Peersen/Blinkenlights/PCB_Blinkenlights_Stubnitz/Blinkenlights_Stubnitz/Blinkenlights_Stubnitz.jpg

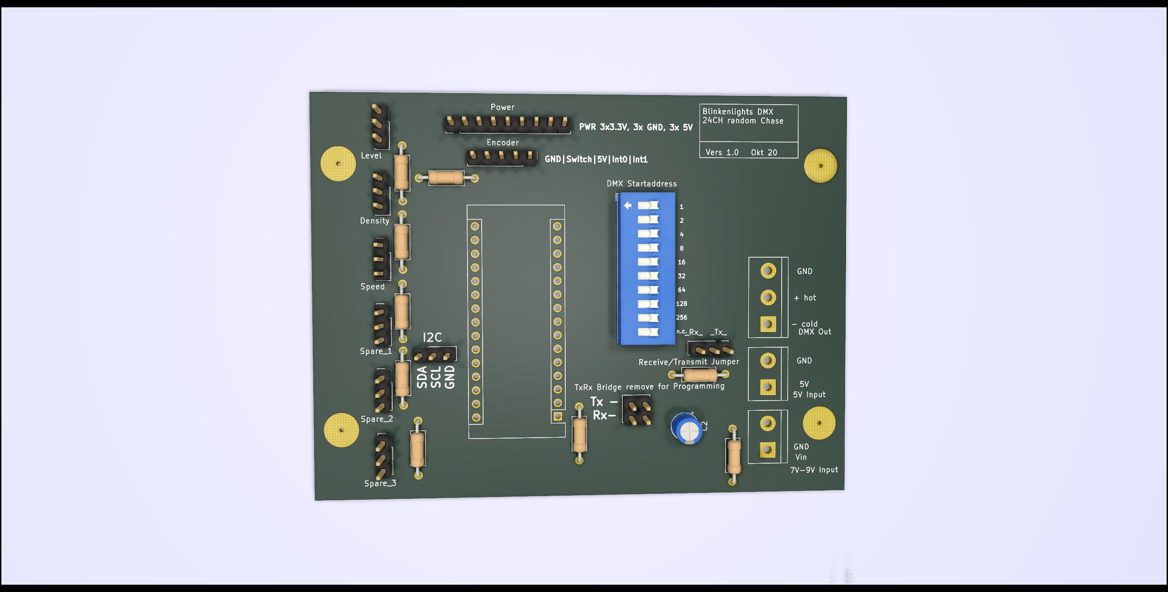
PCB_Blinkenlights_Stubnitz/Blinkenlights_Stubnitz/Blinkenlights_Stubnitz.jpg
