Peersen/Blinkenlights/PCB_Blinkenlights_Stubnitz/Blinkenlights_Stubnitz/Schematic.pdf

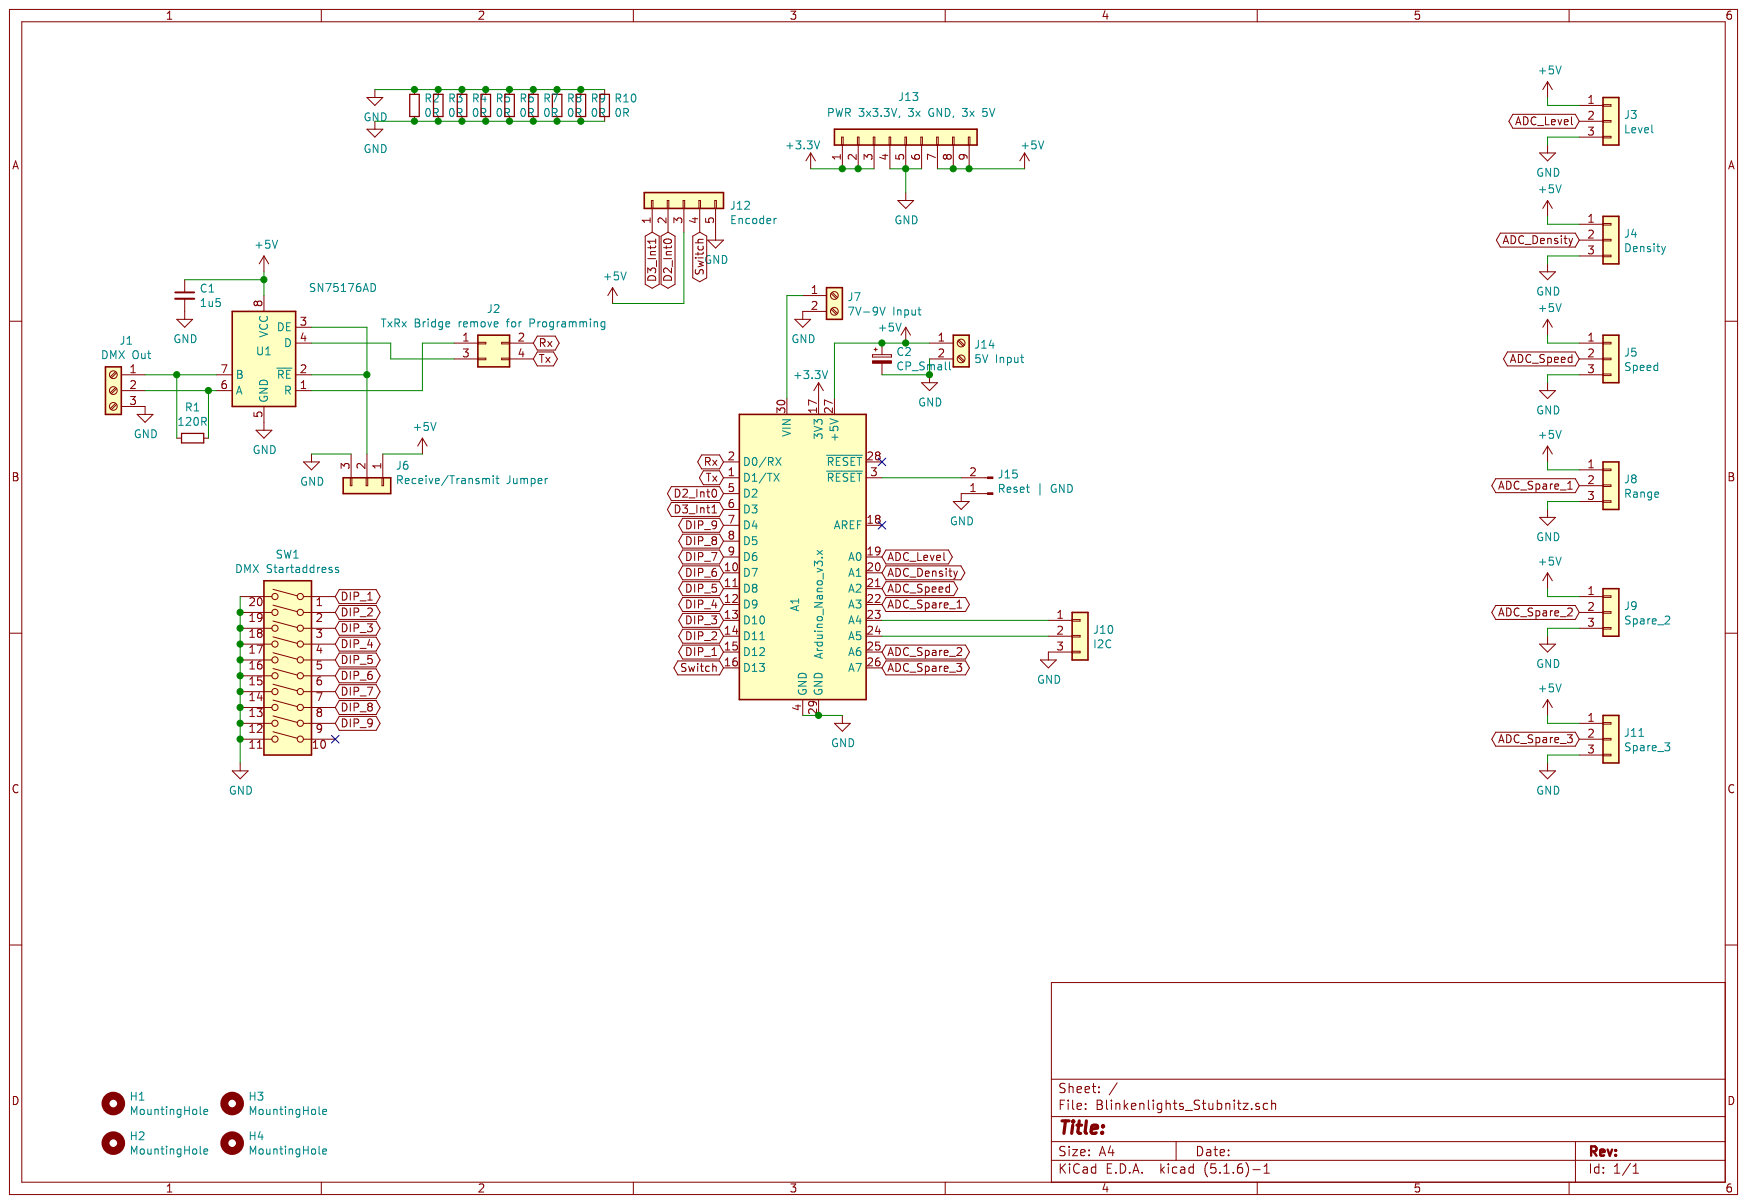
[picture p2: page 1]
