Peersen/Blinkenlights/PCB_Blinkenlights_Stubnitz/Blinkenlights_Stubnitz/Ätzmasken/B_Cu.pdf

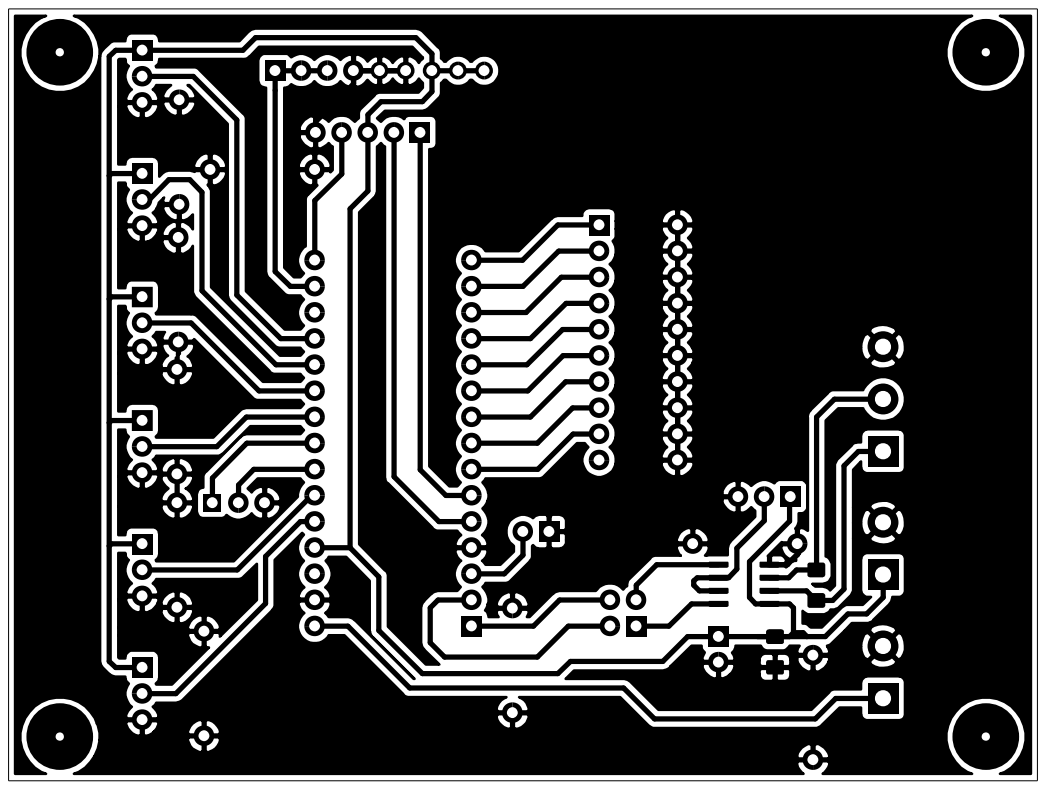
[picture p3: page 1]
