Peersen/Blinkenlights/PCB_Blinkenlights_Stubnitz/Blinkenlights_Stubnitz/Ätzmasken/F_Silk.pdf

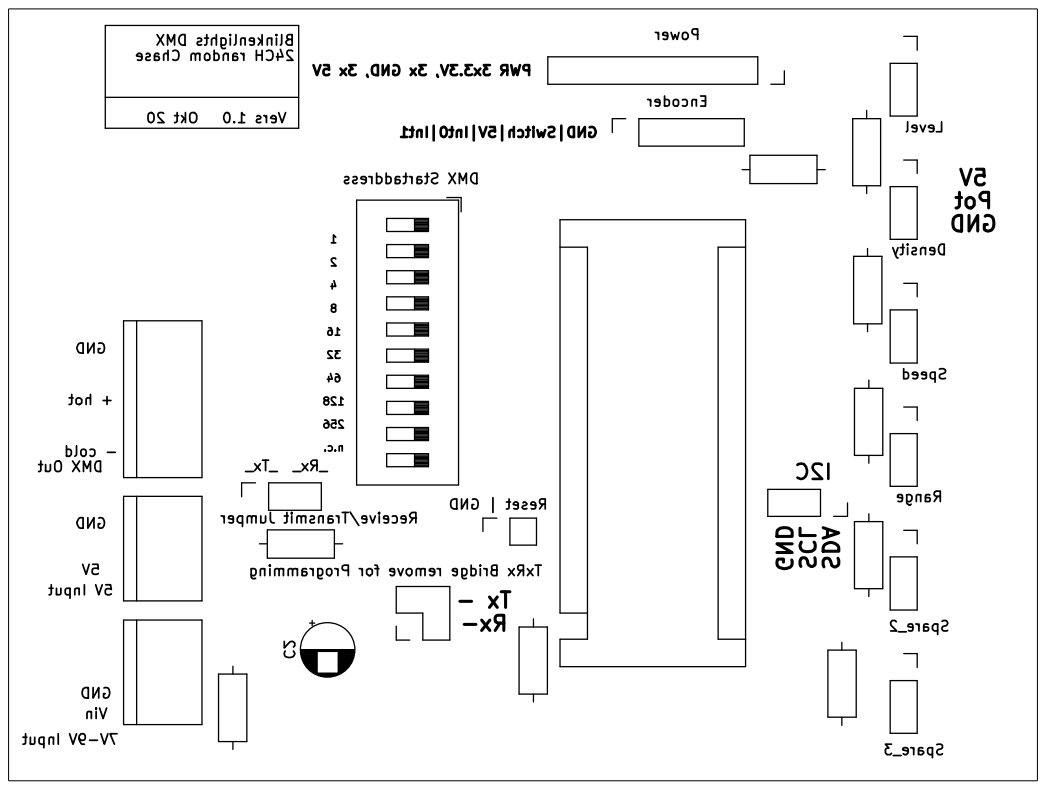
[picture p4: page 1]
