Peersen/Blinkenlights/PCB_Blinkenlights_Stubnitz/Blinkenlights_Stubnitz/Blinkenlights_Stubnitz.kicad_pcb

## KiCad design PCB_Blinkenlights_Stubnitz/Blinkenlights_Stubnitz/Blinkenlights_Stubnitz.kicad_pcb (2020-11-02)

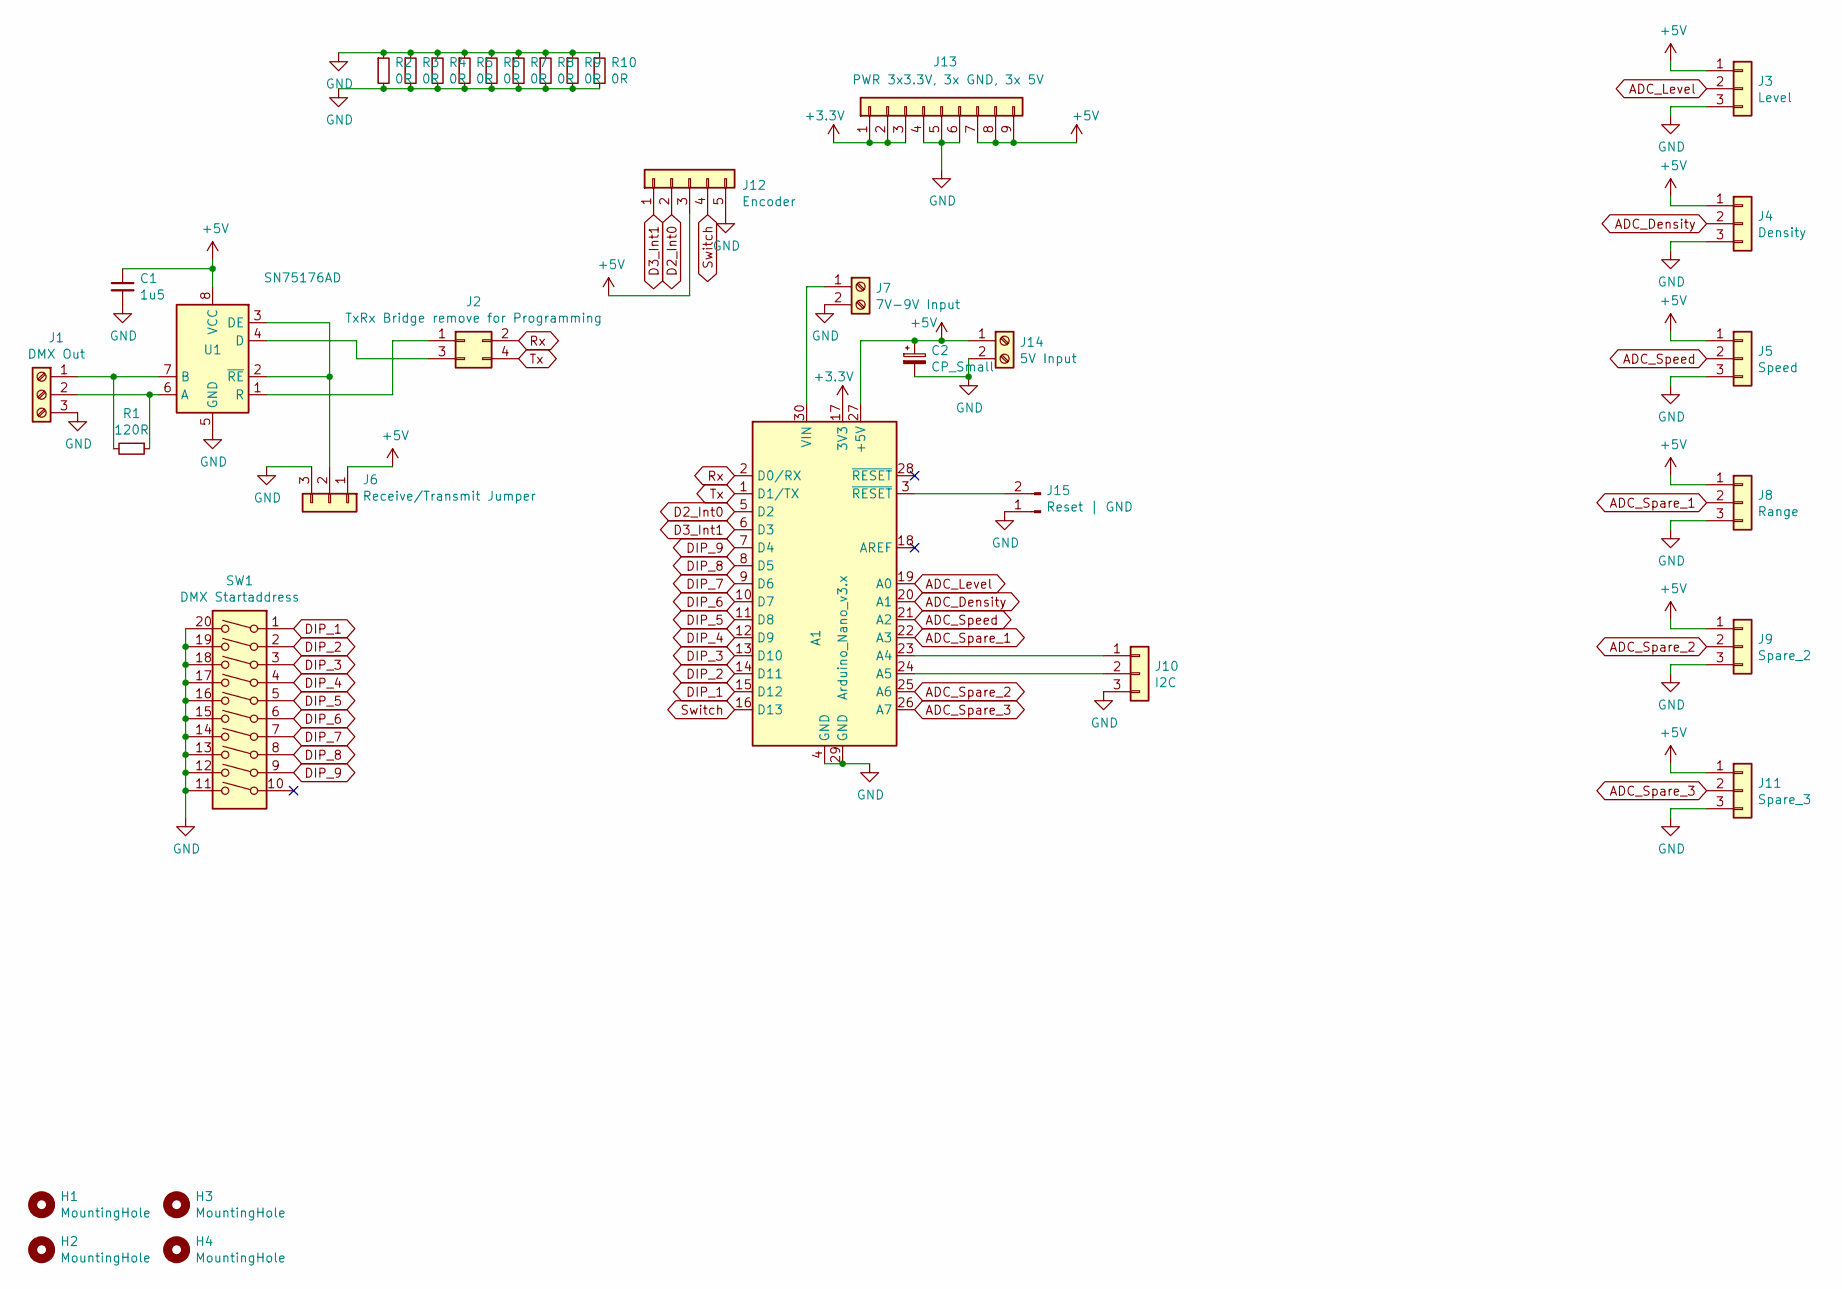
[picture p5: schematic Blinkenlights_Stubnitz.sch]

Parts:
A1: Arduino_Nano_v3.x; Arduino_Nano
C1: 1u5; C_1206_3216Metric_Pad1.42x1.75mm_HandSolder
C2: CP_Small; CP_Radial_D5.0mm_P2.50mm
H1, H2, H3, H4: MountingHole; MountingHole_3.2mm_M3_Pad
J1: DMX Out; TerminalBlock_bornier-3_P5.08mm
J2: TxRx Bridge remove for Programming; PinHeader_2x02_P2.54mm_Vertical
J3: Level; PinHeader_1x03_P2.54mm_Vertical
J4: Density; PinHeader_1x03_P2.54mm_Vertical
J5: Speed; PinHeader_1x03_P2.54mm_Vertical
J6: Receive/Transmit Jumper; PinHeader_1x03_P2.54mm_Vertical
J7: 7V-9V Input; TerminalBlock_bornier-2_P5.08mm
J8: Range; PinHeader_1x03_P2.54mm_Vertical
J9: Spare_2; PinHeader_1x03_P2.54mm_Vertical
J10: I2C; PinHeader_1x03_P2.54mm_Vertical
J11: Spare_3; PinHeader_1x03_P2.54mm_Vertical
J12: Encoder; PinHeader_1x05_P2.54mm_Vertical
J13: PWR 3x3.3V, 3x GND, 3x 5V; PinHeader_1x09_P2.54mm_Vertical
J14: 5V Input; TerminalBlock_bornier-2_P5.08mm
J15: Reset | GND; PinHeader_1x02_P2.54mm_Vertical
R1: 120R; R_1206_3216Metric_Pad1.42x1.75mm_HandSolder
R2, R3, R4, R5, R6, R7, R8, R9, R10: 0R; R_Axial_DIN0207_L6.3mm_D2.5mm_P10.16mm_Horizontal
SW1: DMX Startaddress; SW_DIP_SPSTx10_Slide_9.78x27.58mm_W7.62mm_P2.54mm
U1: SN75176AD; SOIC-8_3.9x4.9mm_P1.27mm

Connections:
+3V3: A1.17 (3V3), J13.1, J13.2, J13.3
+5V: A1.27 (+5V), C1.1, C2.1, J3.1, J4.1, J5.1, J6.1, J8.1, J9.1, J11.1, J12.3, J13.7, J13.8, J13.9, J14.1, U1.8 (VCC)
ADC_Density: A1.20 (A1), J4.2
ADC_Level: A1.19 (A0), J3.2
ADC_Spare_1: A1.22 (A3), J8.2
ADC_Spare_2: A1.25 (A6), J9.2
ADC_Spare_3: A1.26 (A7), J11.2
ADC_Speed: A1.21 (A2), J5.2
D2_Int0: A1.5 (D2), J12.2
D3_Int1: A1.6 (D3), J12.1
DIP_1: A1.15 (D12), SW1.1
DIP_2: A1.14 (D11), SW1.2
DIP_3: A1.13 (D10), SW1.3
DIP_4: A1.12 (D9), SW1.4
DIP_5: A1.11 (D8), SW1.5
DIP_6: A1.10 (D7), SW1.6
DIP_7: A1.9 (D6), SW1.7
DIP_8: A1.8 (D5), SW1.8
DIP_9: A1.7 (D4), SW1.9
GND: A1.4 (GND), A1.29 (GND), C1.2, C2.2, J1.3, J3.3, J4.3, J5.3, J6.3, J7.2, J8.3, J9.3, J10.3, J11.3, J12.5, J13.4, J13.5, J13.6, J14.2, J15.1, R2.1, R2.2, R3.1, R3.2, R4.1, R4.2, R5.1, R5.2, R6.1, R6.2, R7.1, R7.2, R8.1, R8.2, R9.1, R9.2, R10.1, R10.2, SW1.11, SW1.12, SW1.13, SW1.14, SW1.15, SW1.16, SW1.17, SW1.18, SW1.19, SW1.20, U1.5 (GND)
unnamed: A1.3 (~RESET), J15.2
unnamed: A1.23 (A4), J10.1
unnamed: A1.24 (A5), J10.2
unnamed: A1.30 (VIN), J7.1
unnamed: J1.1, R1.2, U1.7 (B)
unnamed: J1.2, R1.1, U1.6 (A)
unnamed: J2.1, U1.1 (R)
unnamed: J2.3, U1.4 (D)
unnamed: J6.2, U1.2 (~RE), U1.3 (DE)
Rx: A1.2 (D0/RX), J2.2
Switch: A1.16 (D13), J12.4
Tx: A1.1 (D1/TX), J2.4

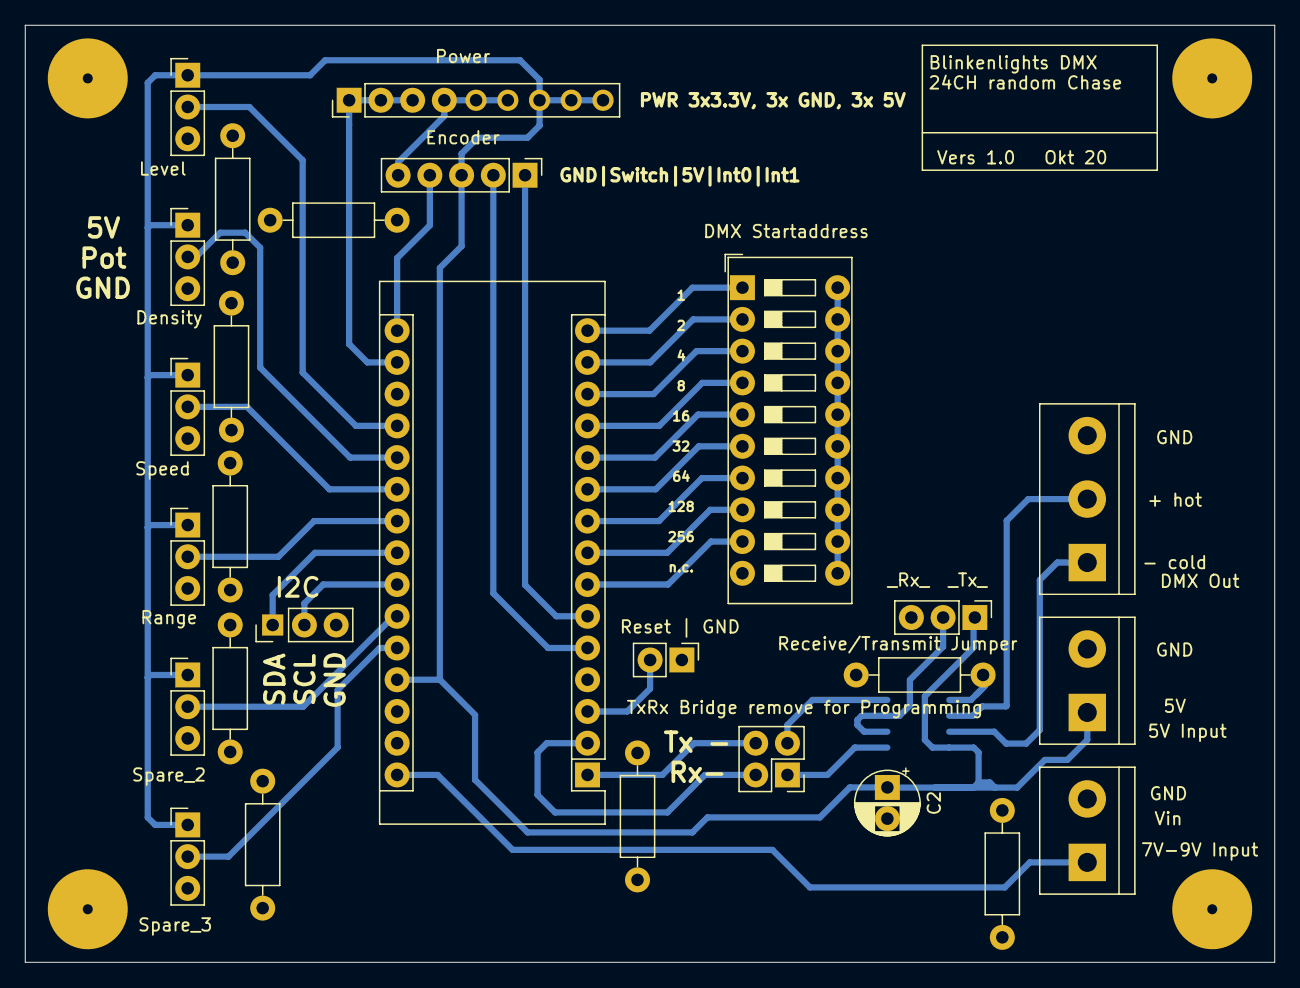
[picture p6: board Blinkenlights_Stubnitz.kicad_pcb from above]

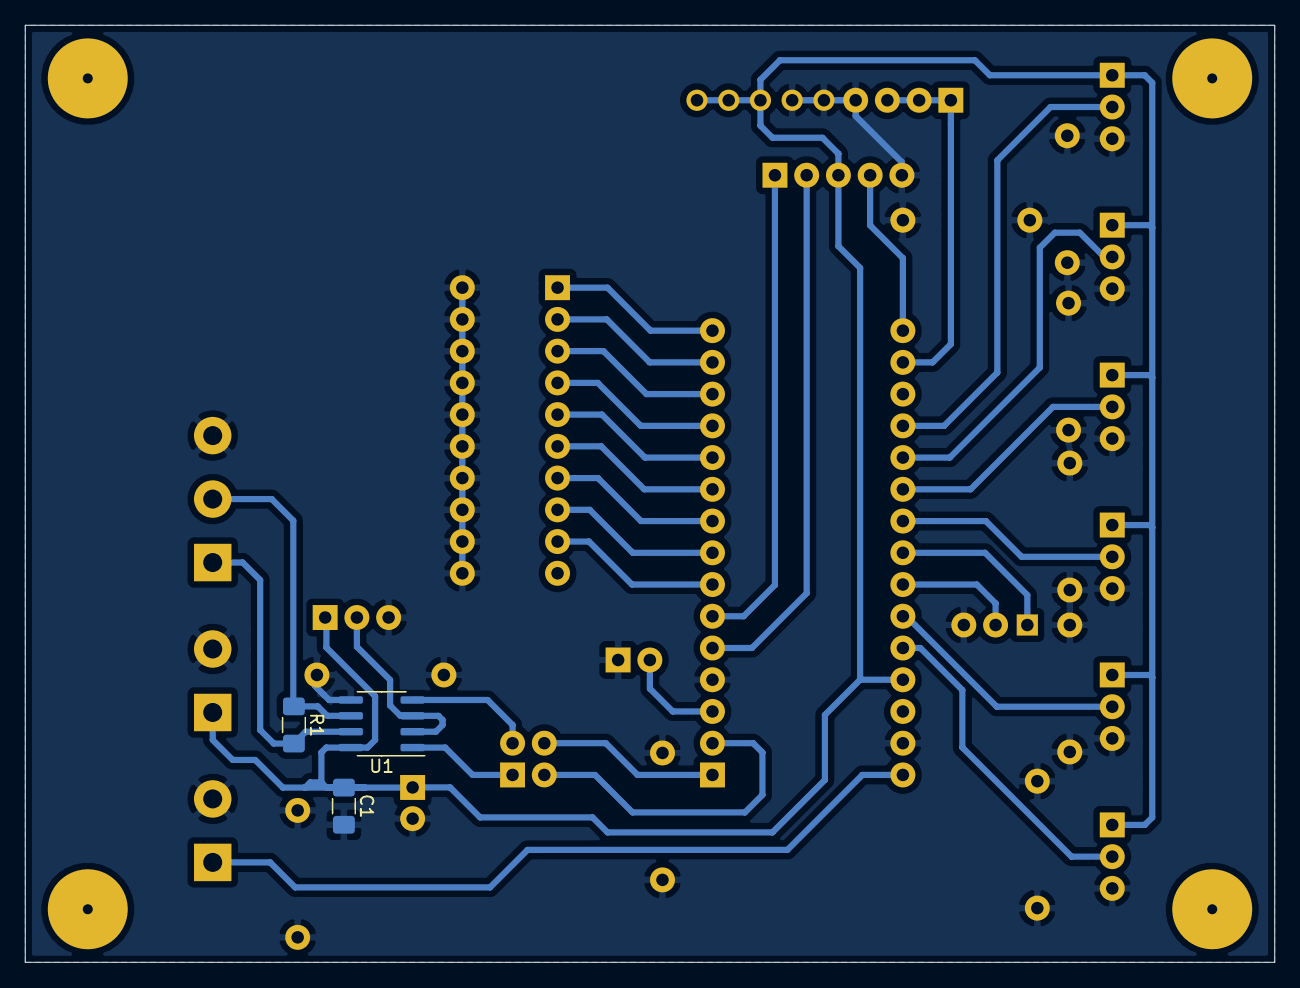
[picture p7: board Blinkenlights_Stubnitz.kicad_pcb from below]

Board: 2 copper layers, 100.0 x 75.0 mm, 34 parts (3 on the bottom side), 32 nets.
