Peersen/Blinkenlights/(commit log)

2020-11-02 adding stuff
    [Blinkenlights_Stubnitz.kicad_pcb, Blinkenlights_Stubnitz.sch]
2020-11-02 schematic as PDF
2020-11-28 decomment printf debugging
